pav2000/Podval/Picture/06.jpg

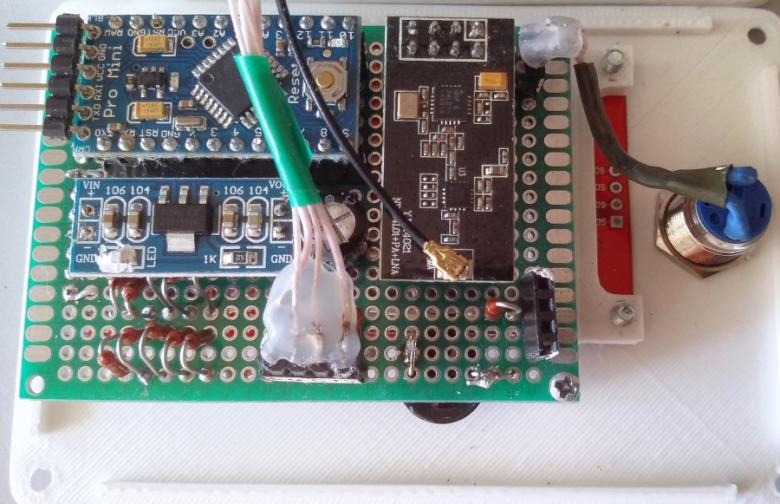
Picture/06.jpg
