pav2000/Podval/Picture/02.jpg

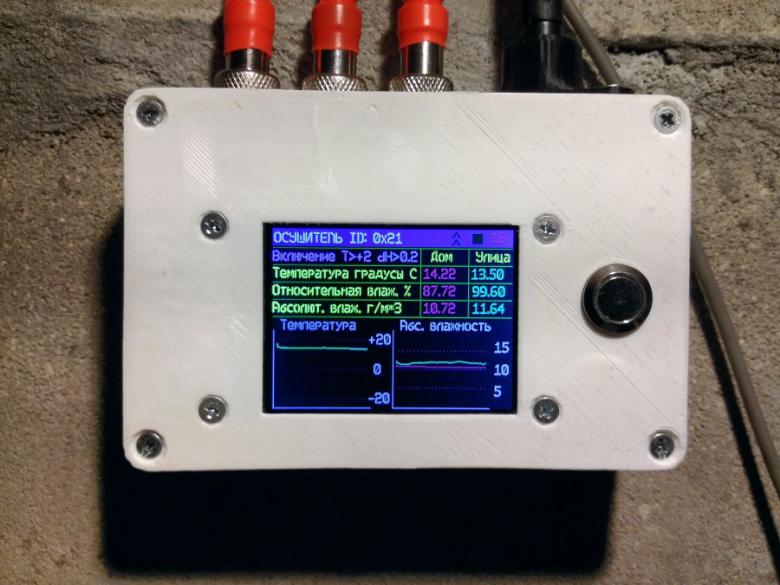
Picture/02.jpg
