pav2000/Podval/Picture/03.jpg

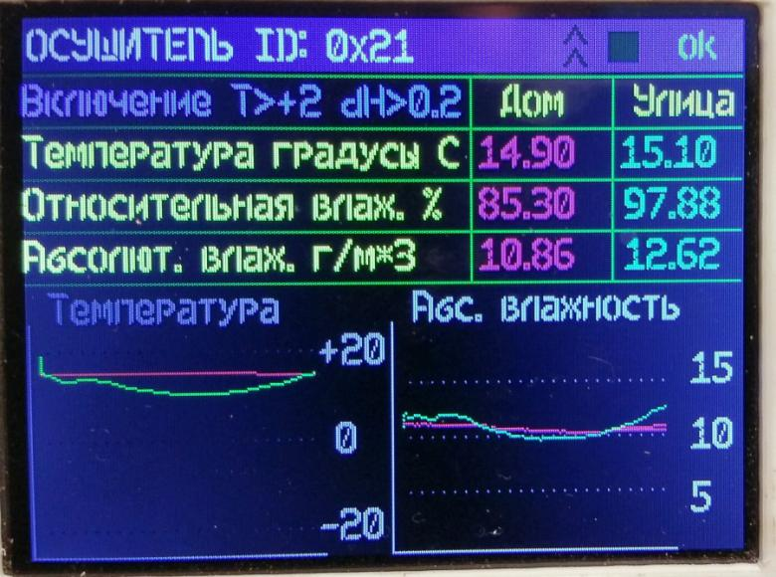
Picture/03.jpg
