pav2000/Podval/Picture/04.jpg

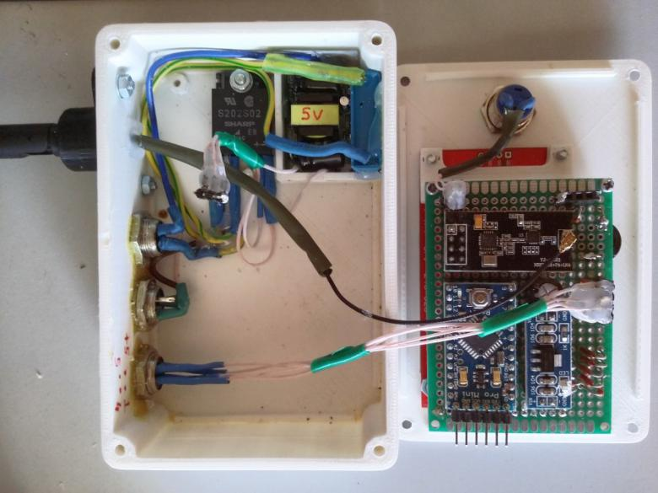
Picture/04.jpg
