pav2000/Podval/Picture/07.jpg

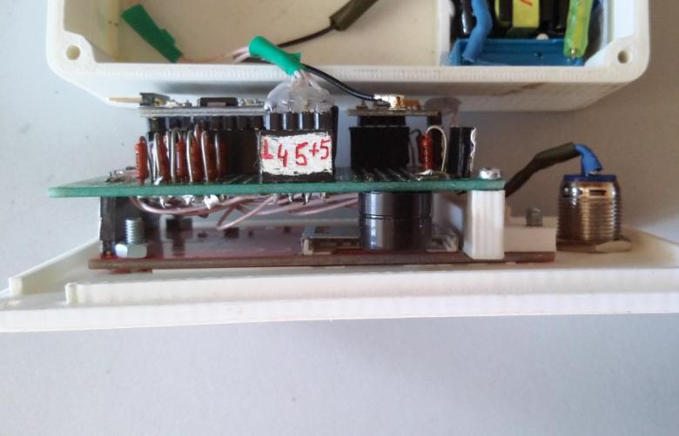
Picture/07.jpg
