pav2000/Podval/Picture/shema.png

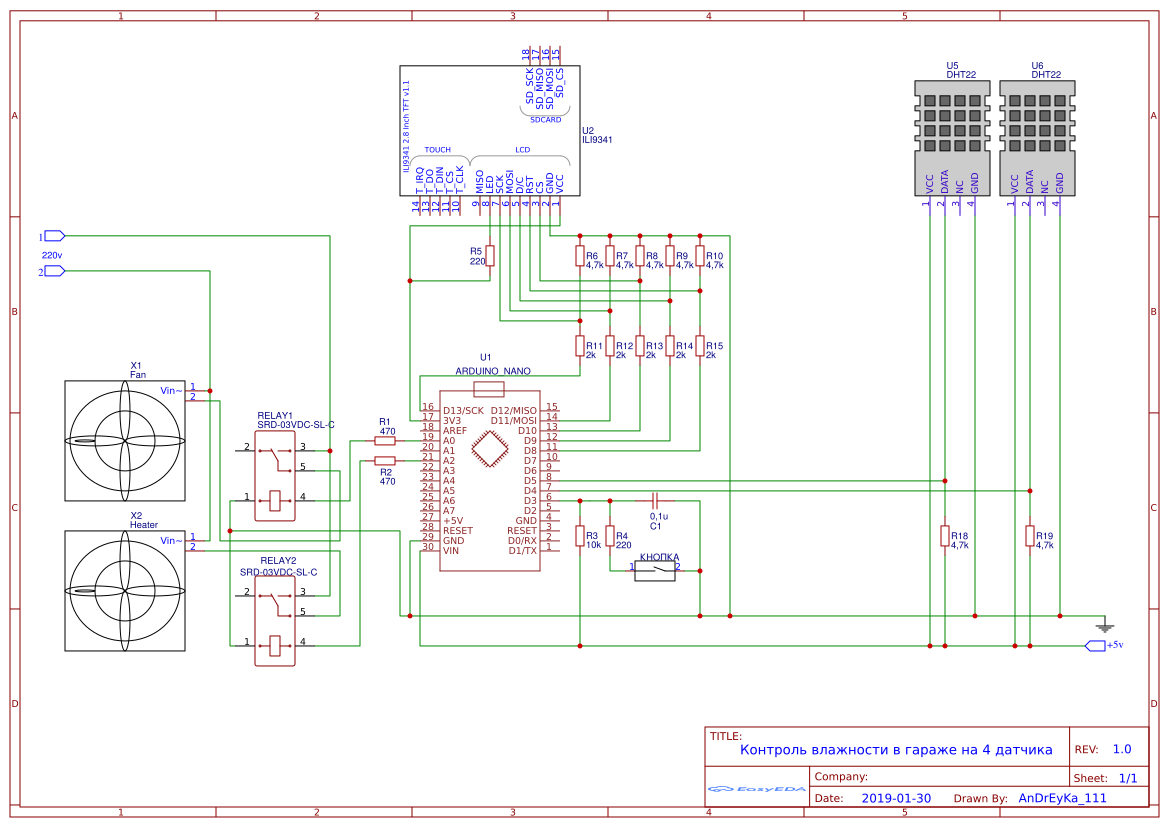
Picture/shema.png
