pav2000/Podval/Podval/rusFont.h

// Русский шрифт 10х14 ------------------------------------------------------
const ucg_fntpgm_uint8_t my14x10rus[4157] UCG_SECTION(".progmem.my14x10") = {
  0,11,15,0,255,14,3,35,6,248,32,255,0,15,255,14,
  0,0,0,0,8,0,0,2,14,14,4,1,0,64,192,192,
  192,192,192,192,192,192,128,0,64,192,128,6,5,5,7,0,
  9,68,204,204,204,136,10,14,28,11,0,0,8,128,8,128,
  17,0,17,0,127,192,17,0,17,0,34,0,34,0,255,128,
  34,0,34,0,68,0,68,0,9,14,28,10,0,0,8,0,
  8,0,59,128,123,0,200,0,200,0,232,0,107,0,11,128,
  9,128,9,128,111,0,238,0,8,0,8,14,14,9,0,0,
  97,179,214,102,12,12,24,24,48,48,102,107,205,134,9,14,
  28,10,0,0,56,0,124,0,108,0,108,0,108,0,56,0,
  56,128,109,128,199,0,194,0,199,0,237,128,124,128,56,0,
  2,5,5,3,0,10,128,192,192,192,64,5,14,14,6,0,
  0,24,48,96,96,192,192,192,192,192,192,96,96,48,24,5,
  14,14,6,0,0,192,96,48,48,24,24,24,24,24,24,56,
  48,96,192,7,7,7,8,0,4,146,214,124,16,124,214,146,
  8,10,10,10,0,1,8,24,24,24,127,254,24,24,24,16,
  4,6,6,5,0,0,112,96,96,64,192,192,8,2,2,9,
  0,5,127,254,3,3,3,4,0,0,224,160,224,8,14,14,
  9,0,0,3,3,6,6,12,12,24,24,48,48,96,96,192,
  192,9,14,28,10,0,0,62,0,127,0,227,128,197,128,197,
  128,197,128,201,128,201,128,209,128,209,128,209,128,227,128,127,
  0,62,0,9,14,28,10,0,0,12,0,28,0,60,0,124,
  0,8,0,4,0,12,0,12,0,8,0,4,0,12,0,12,
  0,127,128,255,128,9,14,28,10,0,0,126,0,255,0,195,
  128,193,128,1,128,3,128,63,0,126,0,224,0,192,0,192,
  0,192,0,223,128,191,0,9,14,28,10,0,0,126,0,255,
  0,195,128,1,128,1,128,3,0,58,0,119,0,3,128,1,
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
  38,97,18,119,76,194,104,200,73,0,68,21,247,252,9,67,
  86,10,147,48,9,147,48,9,147,48,201,162,33,167,1,69,
  14,247,252,9,151,184,60,100,113,243,176,83,0,70,13,247,
  252,9,151,184,60,100,113,119,50,0,71,20,247,252,41,67,
  20,38,97,18,151,150,48,9,147,76,90,114,10,0,72,22,
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
