pav2000/Podval/(commit log)

2019-01-30 Заливка проекта
2019-01-30 Добавлено описание
2019-01-30 Добавлены картинки
2019-01-31 Добвлена схема
